penguineer/CloudTempSensor/README.txt

ESP-based Temperature Sensor with Cloud logging.

Uses https://github.com/jdunmire/kicad-ESP8266
