penguineer/CloudTempSensor/Board/Board.kicad_pcb

## KiCad design Board/Board.kicad_pcb (2018-09-24)

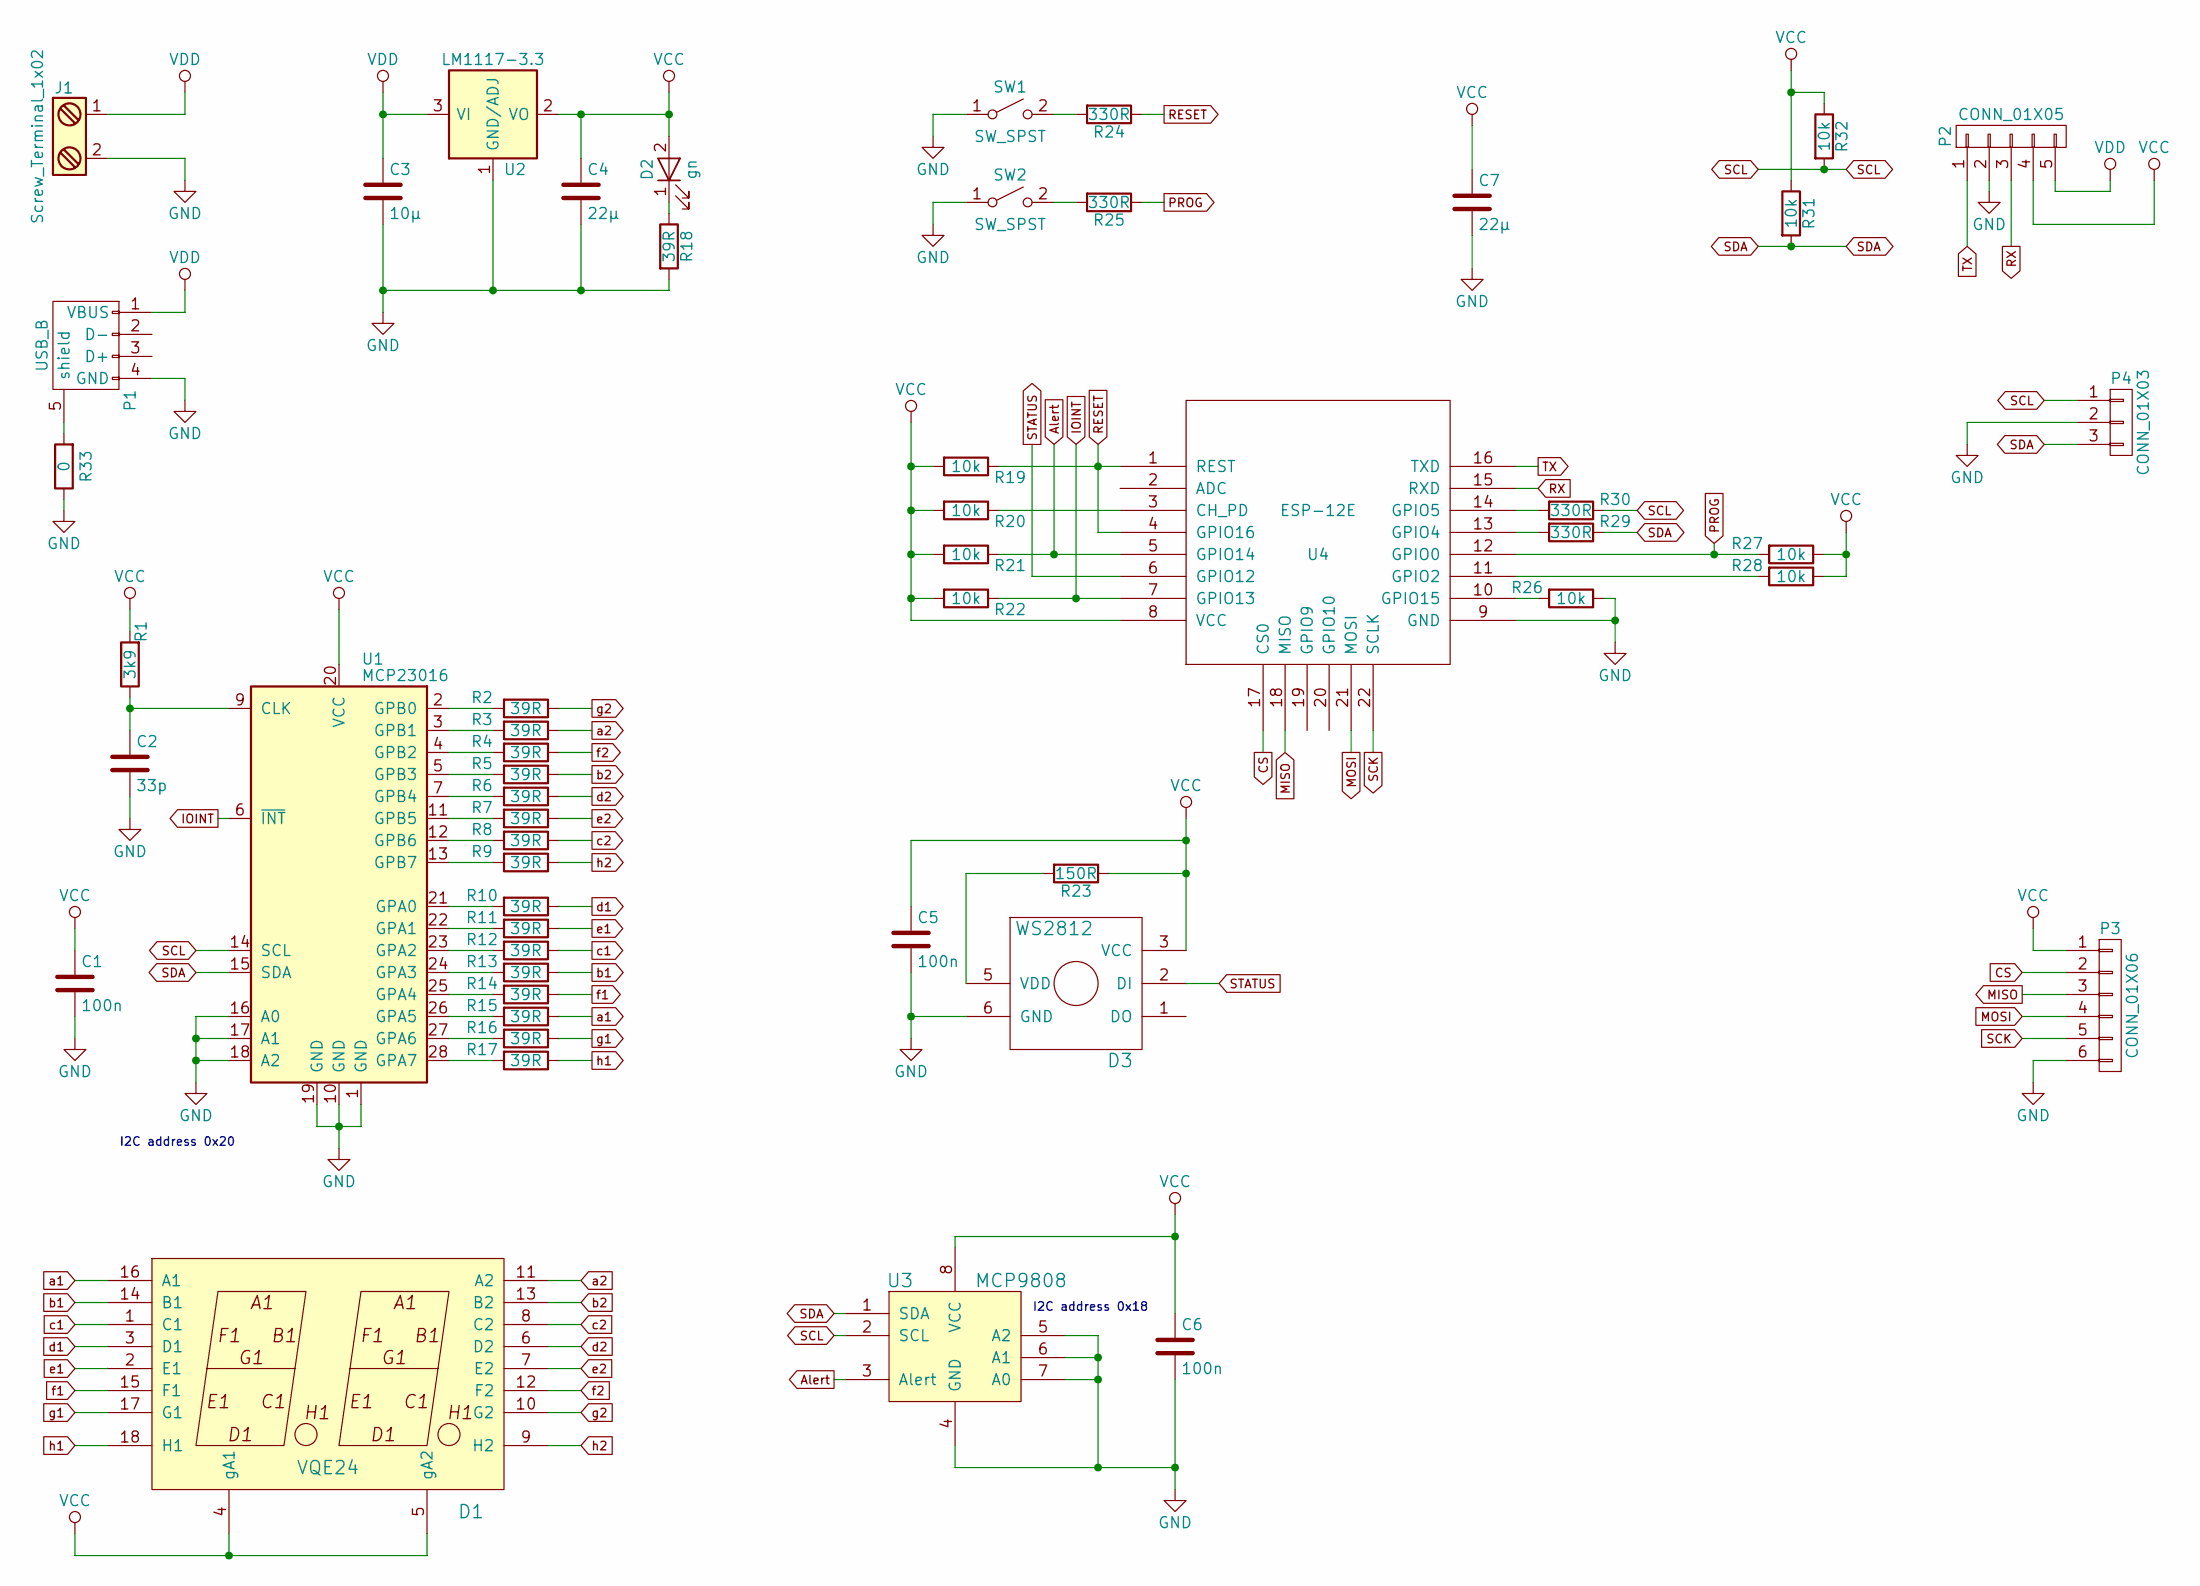
[picture p1: schematic Board.sch, Cloud Temperature Sensor]

Parts:
C1, C5, C6: 100n; C_0603_HandSoldering
C2: 33p; C_0603_HandSoldering
C3: 10µ; C_1206_HandSoldering
C4, C7: 22µ; C_1206_HandSoldering
D1: VQE24
D2: gn; LED_1206
D3: WS2812; LED_WS2812-PLCC6
J1: Screw_Terminal_1x02; AKL_101-02
P1: USB_B; USB_Micro-B
P2: CONN_01X05; Socket_Strip_Straight_1x05
P3: CONN_01X06; Socket_Strip_Straight_1x06
P4: CONN_01X03; Pin_Header_Straight_1x03
R1: 3k9; R_0603_HandSoldering
R2, R3, R4, R5, R6, R7, R8, R9, R10, R11, R12, R13, R14, R15, R16, R17, R18: 39R; R_0603_HandSoldering
R19, R20, R21, R22, R26, R27, R28, R31, R32: 10k; R_0603_HandSoldering
R23: 150R; R_0603_HandSoldering
R24, R25, R29, R30: 330R; R_0603_HandSoldering
R33: 0; R_0603_HandSoldering
SW1, SW2: SW_SPST; SW_SPST_EVQPE1
U1: MCP23016; SOIC-28W_7.5x17.9mm_Pitch1.27mm
U2: LM1117-3.3; SOT-223
U3: MCP9808; MSOP-8_3x3mm_Pitch0.65mm
U4: ESP-12E

Connections:
Alert: R21.1, U3.3 (Alert), U4.5 (GPIO14)
CS: P3.2, U4.17 (CS0)
GND: C1.2, C2.2, C3.2, C4.2, C5.2, C6.2, C7.2, D3.6 (GND), J1.2, P1.4 (GND), P2.2, P3.6, P4.2, R18.2, R26.1, R33.1, SW1.1 (A), SW2.1 (A), U1.1 (GND), U1.10 (GND), U1.16 (A0), U1.17 (A1), U1.18 (A2), U1.19 (GND), U2.1 (GND/ADJ), U3.4 (GND), U3.5 (A2), U3.6 (A1), U3.7 (A0), U4.9 (GND)
IOINT: R22.1, U1.6 (~INT), U4.7 (GPIO13)
MISO: P3.3, U4.18 (MISO)
MOSI: P3.4, U4.21 (MOSI)
unnamed: C2.1, R1.1, U1.9 (CLK)
unnamed: D2.1 (K), R18.1
unnamed: D3.5 (VDD), R23.2
unnamed: P1.5 (shield), R33.2
unnamed: R2.2, U1.2 (GPB0)
unnamed: R3.2, U1.3 (GPB1)
unnamed: R4.2, U1.4 (GPB2)
unnamed: R5.2, U1.5 (GPB3)
unnamed: R6.2, U1.7 (GPB4)
unnamed: R7.2, U1.11 (GPB5)
unnamed: R8.2, U1.12 (GPB6)
unnamed: R9.2, U1.13 (GPB7)
unnamed: R10.2, U1.21 (GPA0)
unnamed: R11.2, U1.22 (GPA1)
unnamed: R12.2, U1.23 (GPA2)
unnamed: R13.2, U1.24 (GPA3)
unnamed: R14.2, U1.25 (GPA4)
unnamed: R15.2, U1.26 (GPA5)
unnamed: R16.2, U1.27 (GPA6)
unnamed: R17.2, U1.28 (GPA7)
unnamed: R20.1, U4.3 (CH_PD)
unnamed: R24.2, SW1.2 (B)
unnamed: R25.2, SW2.2 (B)
unnamed: R26.2, U4.10 (GPIO15)
unnamed: R28.2, U4.11 (GPIO2)
unnamed: R29.2, U4.13 (GPIO4)
unnamed: R30.2, U4.14 (GPIO5)
PROG: R25.1, R27.2, U4.12 (GPIO0)
RESET: R19.1, R24.1, U4.1 (REST), U4.4 (GPIO16)
RX: P2.3, U4.15 (RXD)
SCK: P3.5, U4.22 (SCLK)
SCL: P4.1, R30.1, R32.2, U1.14 (SCL), U3.2 (SCL)
SDA: P4.3, R29.1, R31.2, U1.15 (SDA), U3.1 (SDA)
STATUS: D3.2 (DI), U4.6 (GPIO12)
TX: P2.1, U4.16 (TXD)
VCC: C1.1, C4.1, C5.1, C6.1, C7.1, D1.4 (gA1), D1.5 (gA2), D2.2 (A), D3.3 (VCC), P2.4, P3.1, R1.2, R19.2, R20.2, R21.2, R22.2, R23.1, R27.1, R28.1, R31.1, R32.1, U1.20 (VCC), U2.2 (VO), U2.4 (VO), U3.8 (VCC), U4.8 (VCC)
VDD: C3.1, J1.1, P1.1 (VBUS), P2.5, U2.3 (VI)
a1: D1.16 (A1), R15.1
a2: D1.11 (A2), R3.1
b1: D1.14 (B1), R13.1
b2: D1.13 (B2), R5.1
c1: D1.1 (C1), R12.1
c2: D1.8 (C2), R8.1
d1: D1.3 (D1), R10.1
d2: D1.6 (D2), R6.1
e1: D1.2 (E1), R11.1
e2: D1.7 (E2), R7.1
f1: D1.15 (F1), R14.1
f2: D1.12 (F2), R4.1
g1: D1.17 (G1), R16.1
g2: D1.10 (G2), R2.1
h1: D1.18 (H1), R17.1
h2: D1.9 (H2), R9.1

Notes on the sheet:
I2C address 0x18
I2C address 0x20

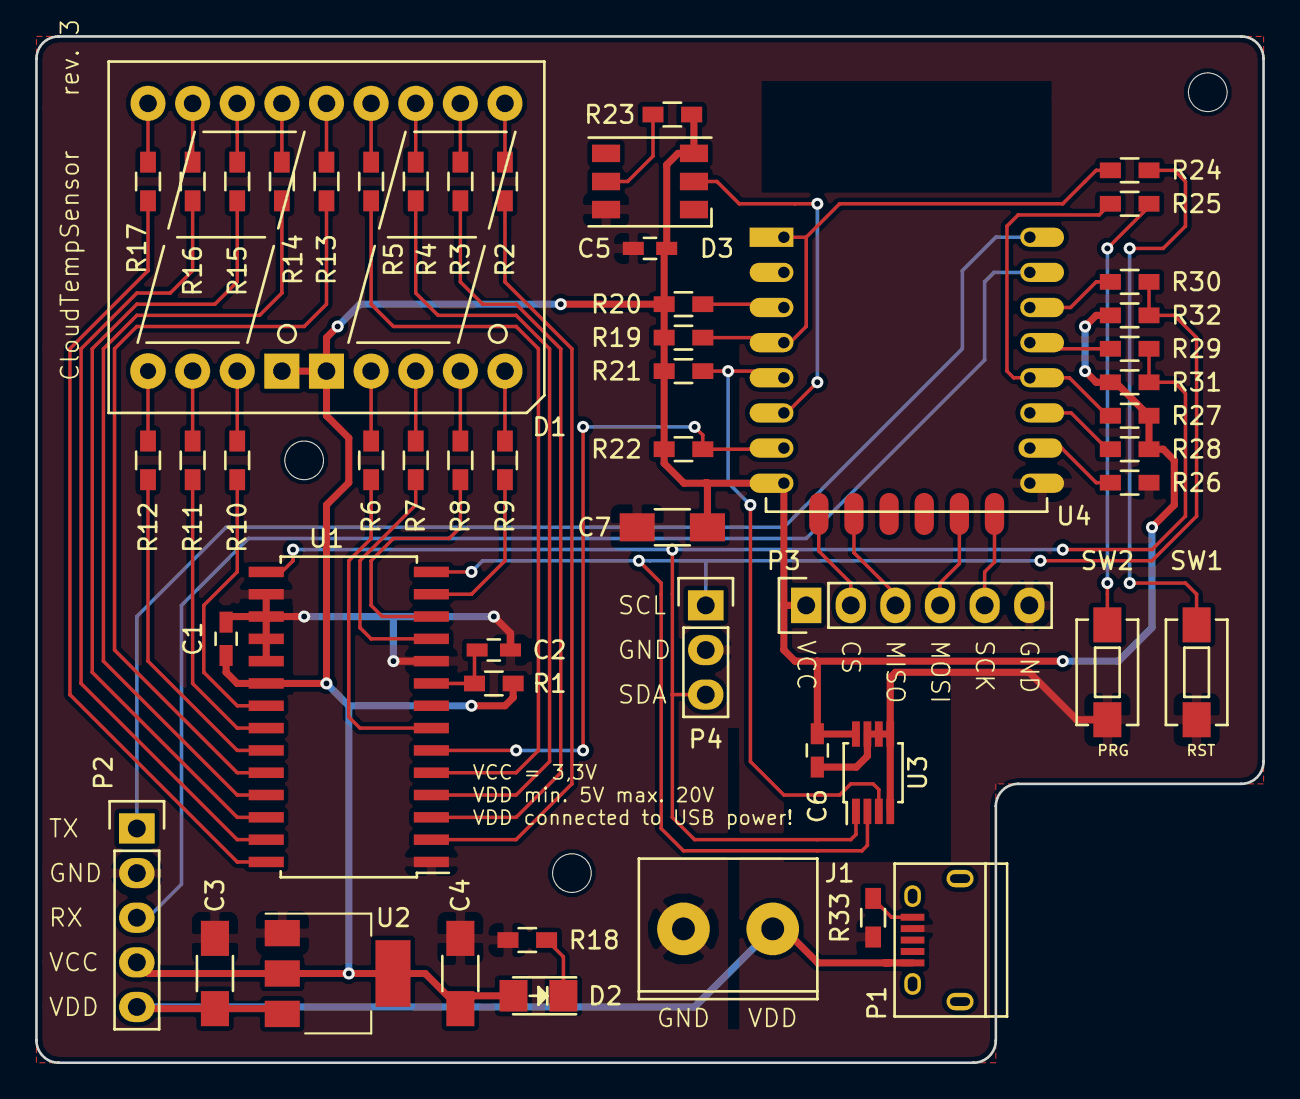
[picture p2: board Board.kicad_pcb from above]

Board: 2 copper layers, 69.9 x 58.4 mm, 54 parts (0 on the bottom side), 59 nets.
