penguineer/CloudTempSensor/(threads)

Thread 1 (2018-04-17):

Add missing footprints

penguineer, 2018-04-17:
Missing footprints:
* switches
* J3 (SPI jumper)

penguineer, 2018-04-21:
Fixed in 4c5309195f2284012a1ba865f59f7696287e5ca6

Closed 2018-04-21.
