penguineer/CloudTempSensor/(commit log)

2017-04-02 Organize temperature sensor functions
2017-04-02 Clean-up the connection failure handling
    Go to config mode, when connection cannot be established during setup, otherwise reboot the device if the connection has been lost.
    [EspFirmware.ino]
2017-04-02 Clean-up state LED naming and usage
    Only one state LED is left and the sybmols have consistent naming.
2017-04-13 Add Update UART command
2018-04-14 gitignore for kicad projects
2018-04-14 First go on schematic
    7-segment controller does not work out so nicely, better use
    a port expander like http://www.ti.com/product/tca9554
    [Board.kicad_pcb, Board.sch]
2018-04-14 Add kicad library link to Readme
2018-04-15 Schematic: 7segment display done
    [Board.sch]
2018-04-15 Power supply
    [Board.sch]
2018-04-15 Power and ESP environment
    [Board.sch]
2018-04-15 Use MCP23016
    [Board.sch]
2018-04-16 WS2812 for status and bypass for ESP
    [Board.sch]
2018-04-16 Footprints and TODOs
    [Board.sch]
2018-04-17 Schematic: final TODOs
    [Board.sch]
2018-04-17 Schematic: Annotate symbols
    [Board.sch]
2018-04-17 Add an SPI connector
    [Board.sch]
2018-04-21 Move some things around in the schematic
    [Board.sch]
2018-04-21 Remaining footprints
    [Board.sch]
2018-04-27 Layout for power and 7 segment display
    [Board.kicad_pcb, Board.sch]
2018-04-27 Layout rev 1
    [Board.kicad_pcb, Board.sch]
2018-04-27 Final Rev 1
    [Board.kicad_pcb, Board.sch]
2018-04-27 Board as sent to DirtyPCB
2018-04-27 sent to dirtypcb
    [Board.kicad_pcb]
2018-07-02 Fix footprint for U1
    [Board.kicad_pcb, Board.sch]
2018-07-15 Board2 sent to DirtyPCBs
2018-08-26 Minimal adaptions for the board
2018-08-26 Board Revision 3: Thermal relief for the temp sensor
    [Board.kicad_pcb, Board.sch]
2018-08-26 I2C connector and more thermal decoupling
    [Board.kicad_pcb, Board.sch]
2018-09-24 Minor changes for rev3
    [Board.kicad_pcb, Board.sch]
2018-09-24 Board revision 3
